ajmath/turn-tracker/hardware/enclosure/brace-bar-detail.png

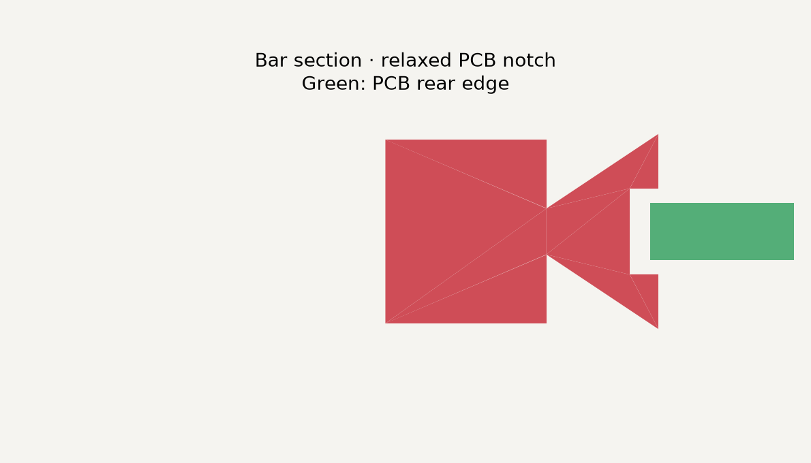
hardware/enclosure/brace-bar-detail.png
