ajmath/turn-tracker/hardware/enclosure/interface-details.png

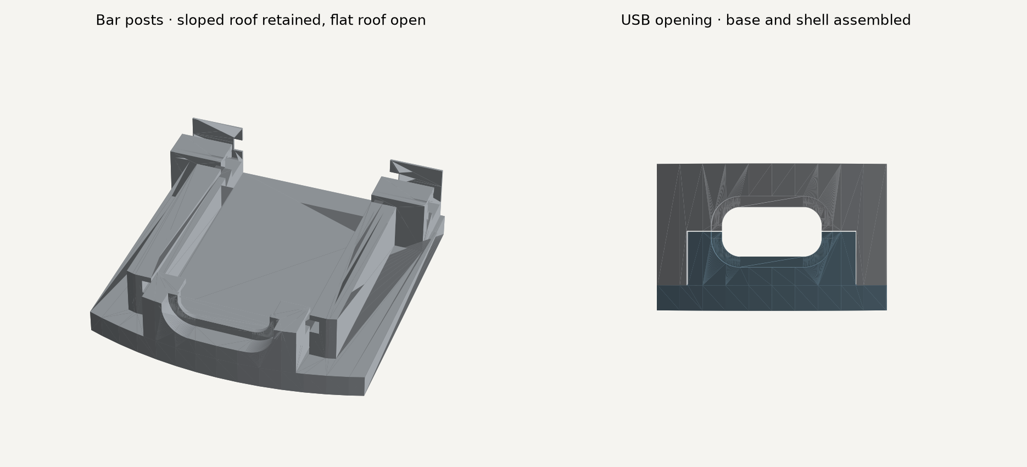
hardware/enclosure/interface-details.png
