ajmath/turn-tracker/hardware/enclosure/preview.png

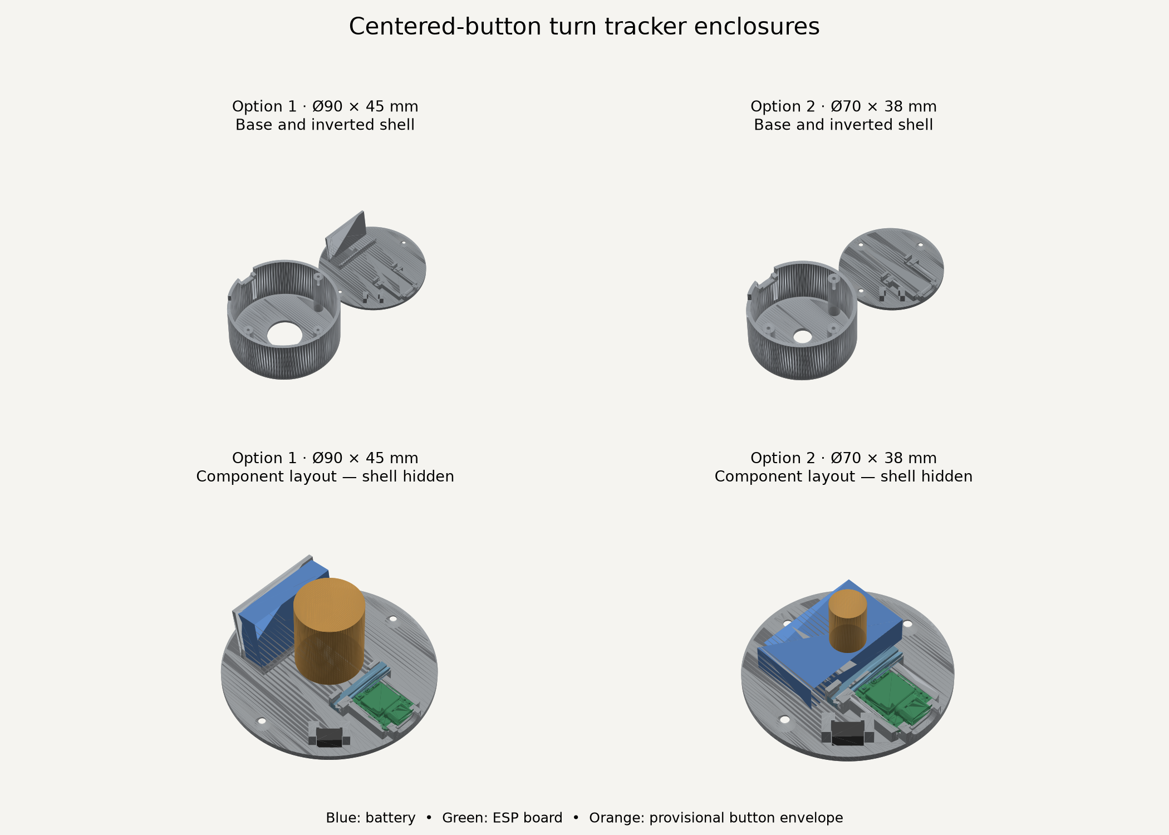
hardware/enclosure/preview.png
