ajmath/turn-tracker/hardware/enclosure/reference/usb.stl

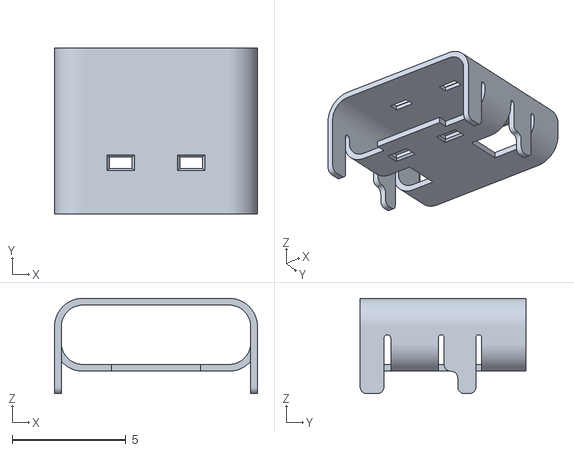
[picture p4: CAD file, 2026-11-03]
hardware/enclosure/reference/usb.stl
8.94 x 7.30 x 4.20
