ajmath/turn-tracker/hardware/enclosure/stl/option-2-component-layout-REFERENCE.stl

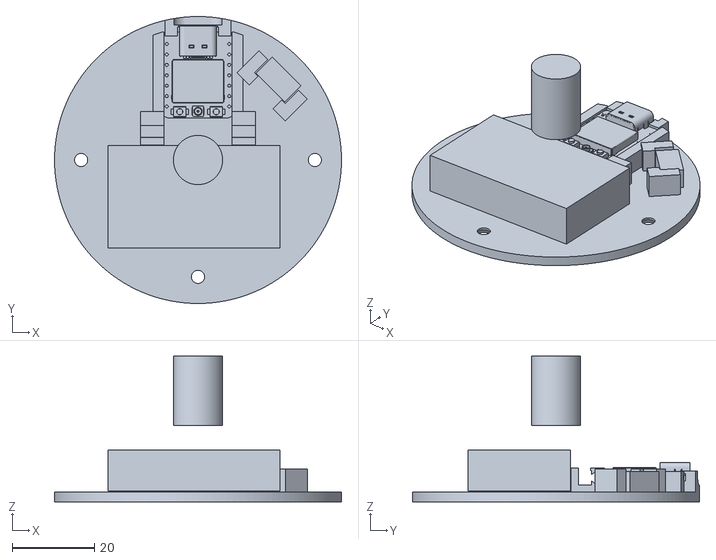
[picture p5: CAD file, 2026-11-06]
hardware/enclosure/stl/option-2-component-layout-REFERENCE.stl
70.0 x 70.0 x 35.6
