ajmath/turn-tracker/hardware/enclosure/reference/board.stl

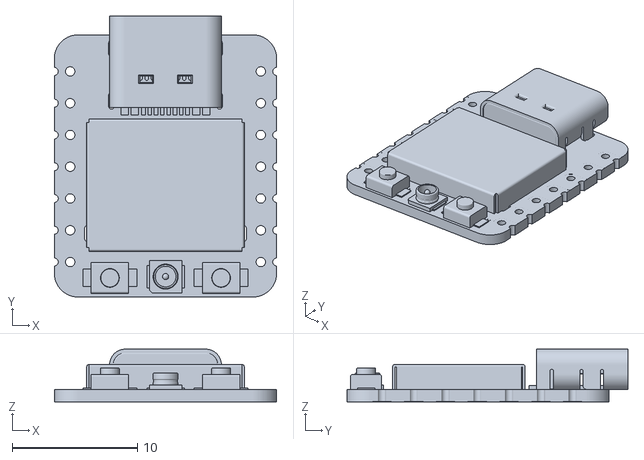
[picture p6: CAD file, 2026-11-03]
hardware/enclosure/reference/board.stl
17.8 x 22.5 x 4.21
