ajmath/turn-tracker/hardware/enclosure/stl/option-1-exploded.stl

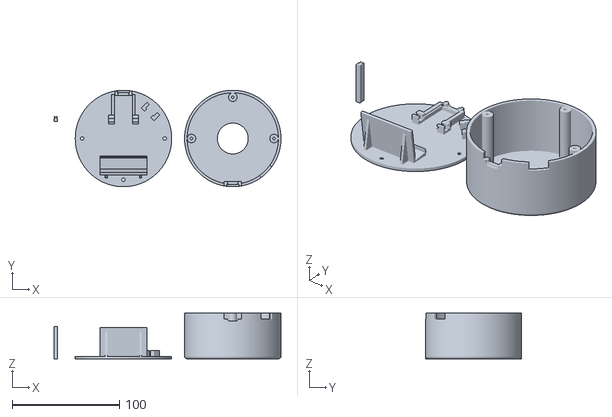
[picture p7: CAD file, 2026-11-06]
hardware/enclosure/stl/option-1-exploded.stl
211.8 x 90.0 x 42.6
