ajmath/turn-tracker/hardware/enclosure/stl/option-2-brace-bar.stl

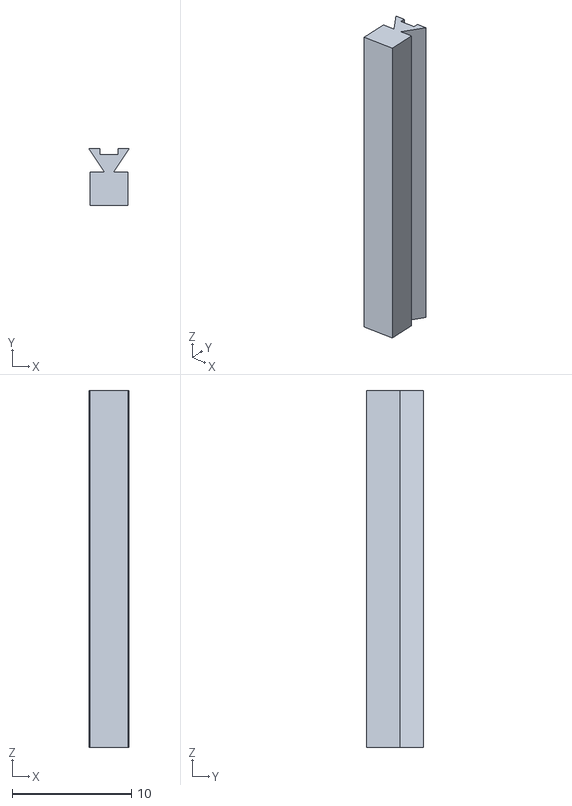
[picture p8: CAD file, 2026-11-06]
hardware/enclosure/stl/option-2-brace-bar.stl
3.40 x 4.75 x 30.0
