ajmath/turn-tracker/hardware/enclosure/stl/option-2-exploded.stl

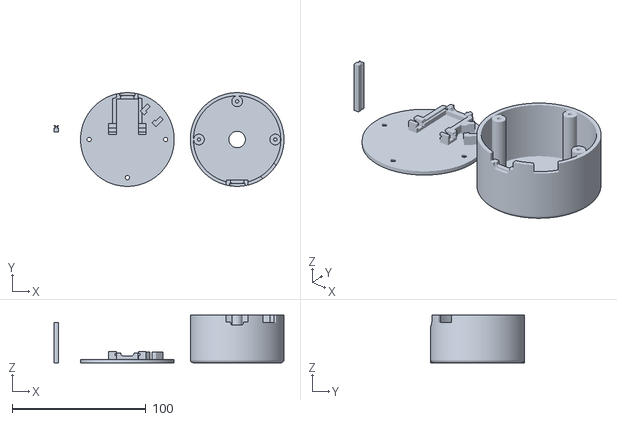
[picture p9: CAD file, 2026-11-06]
hardware/enclosure/stl/option-2-exploded.stl
171.8 x 70.0 x 35.6
