ajmath/turn-tracker/hardware/enclosure/stl/option-2-base.stl

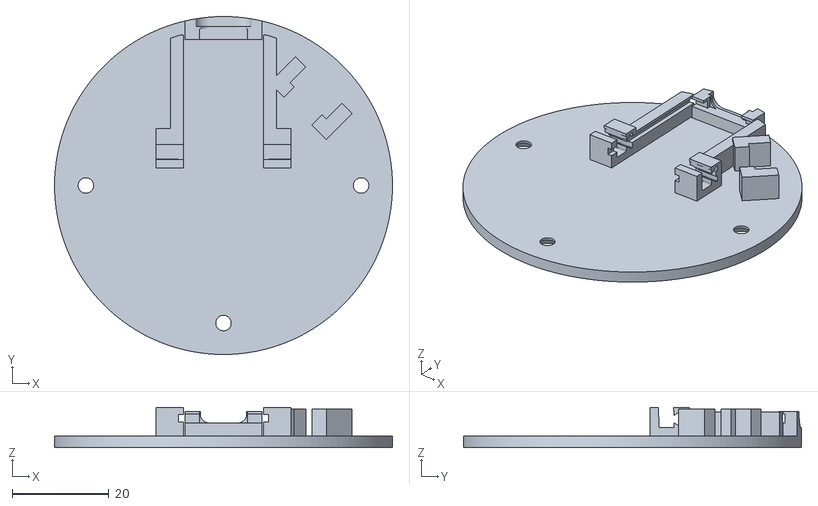
[picture p10: CAD file, 2026-11-06]
hardware/enclosure/stl/option-2-base.stl
70.0 x 70.0 x 8.30
