ajmath/turn-tracker/hardware/enclosure/stl/option-1-base.stl

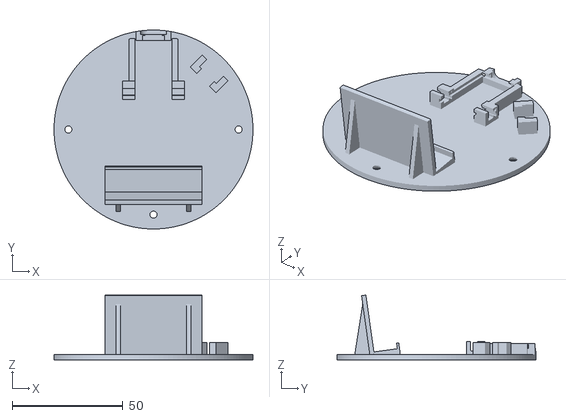
[picture p11: CAD file, 2026-11-06]
hardware/enclosure/stl/option-1-base.stl
90.0 x 90.0 x 29.3
