ajmath/turn-tracker/hardware/enclosure/stl/option-1-component-layout-REFERENCE.stl

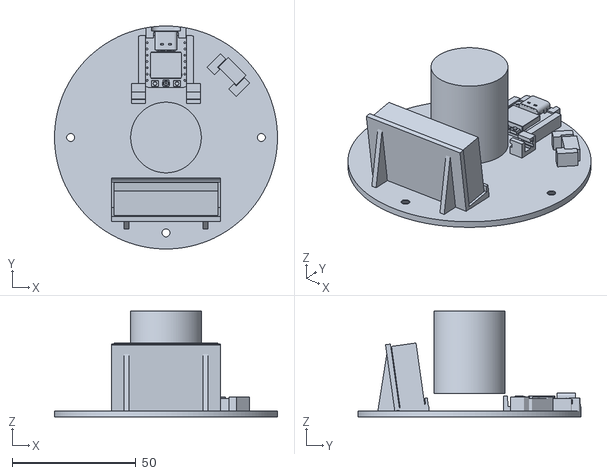
[picture p12: CAD file, 2026-11-06]
hardware/enclosure/stl/option-1-component-layout-REFERENCE.stl
90.0 x 90.0 x 42.6
