ajmath/turn-tracker/hardware/enclosure/stl/option-2-shell.stl

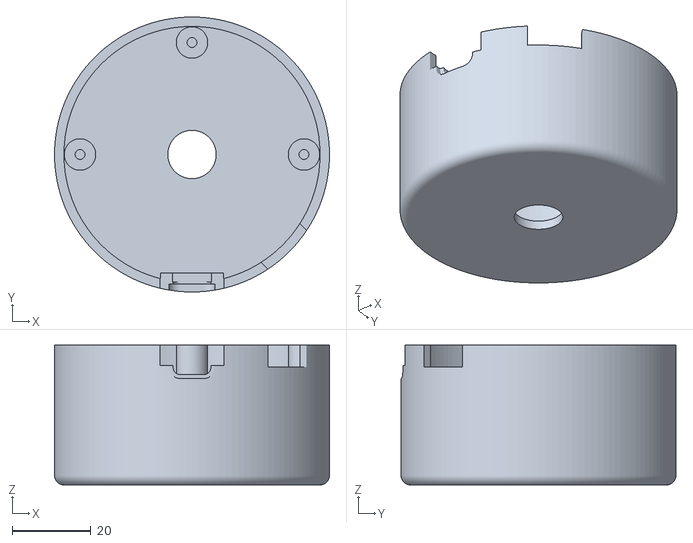
[picture p13: CAD file, 2026-11-03]
hardware/enclosure/stl/option-2-shell.stl
70.0 x 70.0 x 35.6
