ajmath/turn-tracker/hardware/enclosure/stl/option-1-shell.stl

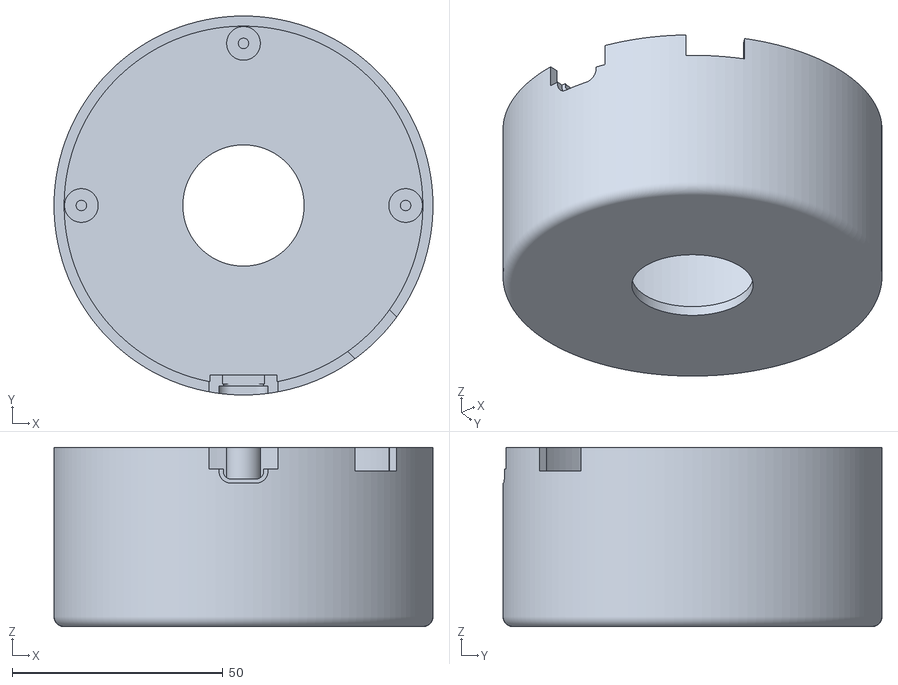
[picture p14: CAD file, 2026-11-03]
hardware/enclosure/stl/option-1-shell.stl
90.0 x 90.0 x 42.6
