ajmath/turn-tracker/hardware/enclosure/option-1.scad

// Option 1: centered button, 90 mm circular puck with local USB recess.
include <puck.scad>
option=1;
