ajmath/turn-tracker/hardware/enclosure/option-2.scad

// Option 2: centered button, 70 mm circular puck with local USB recess.
include <puck.scad>
option=2;
