ajmath/turn-tracker/hardware/enclosure/puck.scad

// Generated by generate.py: exact same CSG tree as the verified STL exports.
// Adjust dimensions in generate.py and regenerate to keep both formats equivalent.
option=1; part="assembly";
module o1_shell(){difference(){difference(){difference(){difference(){union(){difference(){difference(){difference(){difference(){union(){union(){union(){difference(){union(){union(){union(){union(){union(){union(){union(){union(){union(){union(){union(){union(){union(){union(){union(){union(){union(){union(){union(){union(){union(){union(){union(){union(){union(){union(){union(){union(){union(){union(){union(){union(){translate([0,0,2.4]){cylinder(r=45.0,h=40.2,$fn=128);}translate([0,0,42.6]){cylinder(h=0.11776241838580148,r1=45.0,r2=44.997109094892416,$fn=128);}}translate([0,0,42.7177624183858]){cylinder(h=0.11747871840514534,r1=44.997109094892416,r2=44.98844334401328,$fn=128);}}translate([0,0,42.83524113679095]){cylinder(h=0.11691200190192319,r1=44.98844334401328,r2=44.97402362391548,$fn=128);}}translate([0,0,42.95215313869287]){cylinder(h=0.11606363414583853,r1=44.97402362391548,r2=44.95388467296775,$fn=128);}}translate([0,0,43.06821677283871]){cylinder(h=0.11493565892912727,r1=44.95388467296775,r2=44.928075007666905,$fn=128);}}translate([0,0,43.18315243176784]){cylinder(h=0.1135307936428731,r1=44.928075007666905,r2=44.8966568057573,$fn=128);}}translate([0,0,43.29668322541071]){cylinder(h=0.11185242273062102,r1=44.8966568057573,r2=44.859705756439254,$fn=128);}}translate([0,0,43.40853564814133]){cylinder(h=0.10990458953488513,r1=44.859705756439254,r2=44.81731087802709,$fn=128);}}translate([0,0,43.51844023767622]){cylinder(h=0.1076919865564605,r1=44.81731087802709,r2=44.76957430349626,$fn=128);}}translate([0,0,43.62613222423268]){cylinder(h=0.10521994414971658,r1=44.76957430349626,r2=44.716611034436056,$fn=128);}}translate([0,0,43.731352168382394]){cylinder(h=0.10249441768134204,r1=44.716611034436056,r2=44.658548664000655,$fn=128);}}translate([0,0,43.833846586063736]){cylinder(h=0.09952197318330747,r1=44.658548664000655,r2=44.59552706952611,$fn=128);}}translate([0,0,43.93336855924704]){cylinder(h=0.09630977153479847,r1=44.59552706952611,r2=44.52769807555355,$fn=128);}}translate([0,0,44.02967833078184]){cylinder(h=0.092865551210906,r1=44.52769807555355,r2=44.45522508807057,$fn=128);}}translate([0,0,44.12254388199275]){cylinder(h=0.08919760964009527,r1=44.45522508807057,r2=44.378282700851905,$fn=128);}}translate([0,0,44.21174149163284]){cylinder(h=0.0853147832148693,r1=44.378282700851905,r2=44.29705627484771,$fn=128);}}translate([0,0,44.29705627484771]){cylinder(h=0.08122642600419283,r1=44.29705627484771,r2=44.21174149163284,$fn=128);}}translate([0,0,44.378282700851905]){cylinder(h=0.07694238721866498,r1=44.21174149163284,r2=44.12254388199275,$fn=128);}}translate([0,0,44.45522508807057]){cylinder(h=0.07247298748298192,r1=44.12254388199275,r2=44.02967833078184,$fn=128);}}translate([0,0,44.52769807555355]){cylinder(h=0.06782899397256159,r1=44.02967833078184,r2=43.93336855924705,$fn=128);}}translate([0,0,44.59552706952611]){cylinder(h=0.06302159447454159,r1=43.93336855924705,r2=43.833846586063736,$fn=128);}}translate([0,0,44.658548664000655]){cylinder(h=0.05806237043540108,r1=43.833846586063736,r2=43.731352168382394,$fn=128);}}translate([0,0,44.716611034436056]){cylinder(h=0.0529632690602071,r1=43.731352168382394,r2=43.62613222423268,$fn=128);}}translate([0,0,44.76957430349626]){cylinder(h=0.04773657453082336,r1=43.62613222423268,r2=43.51844023767622,$fn=128);}}translate([0,0,44.81731087802709]){cylinder(h=0.042394878412167714,r1=43.51844023767622,r2=43.40853564814133,$fn=128);}}translate([0,0,44.859705756439254]){cylinder(h=0.03695104931804849,r1=43.40853564814133,r2=43.29668322541071,$fn=128);}}translate([0,0,44.8966568057573]){cylinder(h=0.03141820190960232,r1=43.29668322541071,r2=43.18315243176784,$fn=128);}}translate([0,0,44.928075007666905]){cylinder(h=0.02580966530084794,r1=43.18315243176784,r2=43.06821677283871,$fn=128);}}translate([0,0,44.95388467296775]){cylinder(h=0.02013895094772522,r1=43.06821677283871,r2=42.95215313869287,$fn=128);}}translate([0,0,44.97402362391548]){cylinder(h=0.01441972009779846,r1=42.95215313869287,r2=42.83524113679095,$fn=128);}}translate([0,0,44.98844334401328]){cylinder(h=0.008665750879139011,r1=42.83524113679095,r2=42.7177624183858,$fn=128);}}translate([0,0,44.997109094892416]){cylinder(h=0.002890905107584274,r1=42.7177624183858,r2=42.6,$fn=128);}}translate([0,0,2.3]){cylinder(r=42.6,h=40.300000000000004,$fn=128);}}translate([38.5,0.0,2.4]){cylinder(r=4,h=40.2,$fn=128);}}translate([-38.5,4.7148901767173095e-15,2.4]){cylinder(r=4,h=40.2,$fn=128);}}translate([-7.072335265075964e-15,-38.5,2.4]){cylinder(r=4,h=40.2,$fn=128);}}translate([0,0,42.5]){cylinder(r=14.4,h=2.6999999999999997,$fn=128);}}translate([38.5,0.0,2.3]){cylinder(r=1.25,h=10,$fn=128);}}translate([-38.5,4.7148901767173095e-15,2.3]){cylinder(r=1.25,h=10,$fn=128);}}translate([-7.072335265075964e-15,-38.5,2.3]){cylinder(r=1.25,h=10,$fn=128);}}intersection(){translate([-8,40.2,2.4]){cube([16,5.799999999999997,9.6]);}translate([0,0,0]){cylinder(r=45.0,h=45,$fn=128);}}}translate([-8.15,40.050000000000004,2.35]){cube([16.3,6.799999999999997,5.26]);}}union(){union(){union(){union(){union(){union(){translate([-3.0,35.2,5.109999999999999]){cube([6.0,12,4.8]);}translate([-4.8,35.2,6.909999999999999]){cube([9.6,12,1.1999999999999997]);}}translate([-3.0,35.2,6.909999999999999]){rotate([-90,0,0]){translate([0,0,0]){cylinder(r=1.8,h=12,$fn=128);}}}}translate([-3.0,35.2,8.11]){rotate([-90,0,0]){translate([0,0,0]){cylinder(r=1.8,h=12,$fn=128);}}}}translate([3.0,35.2,6.909999999999999]){rotate([-90,0,0]){translate([0,0,0]){cylinder(r=1.8,h=12,$fn=128);}}}}translate([3.0,35.2,8.11]){rotate([-90,0,0]){translate([0,0,0]){cylinder(r=1.8,h=12,$fn=128);}}}}translate([-5,35.2,5.109999999999999]){cube([10,7.2,4.8]);}}}union(){union(){union(){union(){union(){translate([-3.0,42.9,4.109999999999999]){cube([6.0,5,6.8]);}translate([-5.8,42.9,6.909999999999999]){cube([11.6,5,1.2000000000000002]);}}translate([-3.0,42.9,6.909999999999999]){rotate([-90,0,0]){translate([0,0,0]){cylinder(r=2.8,h=5,$fn=128);}}}}translate([-3.0,42.9,8.11]){rotate([-90,0,0]){translate([0,0,0]){cylinder(r=2.8,h=5,$fn=128);}}}}translate([3.0,42.9,6.909999999999999]){rotate([-90,0,0]){translate([0,0,0]){cylinder(r=2.8,h=5,$fn=128);}}}}translate([3.0,42.9,8.11]){rotate([-90,0,0]){translate([0,0,0]){cylinder(r=2.8,h=5,$fn=128);}}}}}rotate([0,0,45]){translate([37.0,-7,2.3]){cube([10,14,5.7]);}}}}
module o1_base(){union(){union(){union(){union(){union(){difference(){difference(){difference(){difference(){difference(){difference(){translate([0,0,0]){cylinder(r=45.0,h=2.4,$fn=128);}translate([38.5,0.0,-0.1]){cylinder(r=1.6,h=2.6,$fn=128);}}translate([38.5,0.0,-0.1]){cylinder(h=2.0,r1=3.6,r2=1.6,$fn=128);}}translate([-38.5,4.7148901767173095e-15,-0.1]){cylinder(r=1.6,h=2.6,$fn=128);}}translate([-38.5,4.7148901767173095e-15,-0.1]){cylinder(h=2.0,r1=3.6,r2=1.6,$fn=128);}}translate([-7.072335265075964e-15,-38.5,-0.1]){cylinder(r=1.6,h=2.6,$fn=128);}}translate([-7.072335265075964e-15,-38.5,-0.1]){cylinder(h=2.0,r1=3.6,r2=1.6,$fn=128);}}difference(){difference(){difference(){intersection(){translate([-8,40.2,2.4]){cube([16,5.799999999999997,5.109999999999999]);}translate([0,0,0]){cylinder(r=45.0,h=45,$fn=128);}}translate([-12,40.1,5.1000000000000005]){cube([24,1.5,1.8]);}}union(){union(){union(){union(){union(){union(){translate([-3.0,35.2,5.109999999999999]){cube([6.0,12,4.8]);}translate([-4.8,35.2,6.909999999999999]){cube([9.6,12,1.1999999999999997]);}}translate([-3.0,35.2,6.909999999999999]){rotate([-90,0,0]){translate([0,0,0]){cylinder(r=1.8,h=12,$fn=128);}}}}translate([-3.0,35.2,8.11]){rotate([-90,0,0]){translate([0,0,0]){cylinder(r=1.8,h=12,$fn=128);}}}}translate([3.0,35.2,6.909999999999999]){rotate([-90,0,0]){translate([0,0,0]){cylinder(r=1.8,h=12,$fn=128);}}}}translate([3.0,35.2,8.11]){rotate([-90,0,0]){translate([0,0,0]){cylinder(r=1.8,h=12,$fn=128);}}}}translate([-5,35.2,5.109999999999999]){cube([10,7.2,4.8]);}}}union(){union(){union(){union(){union(){translate([-3.0,42.9,4.109999999999999]){cube([6.0,5,6.8]);}translate([-5.8,42.9,6.909999999999999]){cube([11.6,5,1.2000000000000002]);}}translate([-3.0,42.9,6.909999999999999]){rotate([-90,0,0]){translate([0,0,0]){cylinder(r=2.8,h=5,$fn=128);}}}}translate([-3.0,42.9,8.11]){rotate([-90,0,0]){translate([0,0,0]){cylinder(r=2.8,h=5,$fn=128);}}}}translate([3.0,42.9,6.909999999999999]){rotate([-90,0,0]){translate([0,0,0]){cylinder(r=2.8,h=5,$fn=128);}}}}translate([3.0,42.9,8.11]){rotate([-90,0,0]){translate([0,0,0]){cylinder(r=2.8,h=5,$fn=128);}}}}}}intersection(){difference(){difference(){union(){translate([-11,20.245000000000005,2.3]){cube([2.7,20.955,5.1]);}difference(){difference(){translate([-14,13.645000000000005,2.3]){cube([5.7,8.2,6.0]);}translate([-20,20.245000000000005,5.4]){rotate([90,0,90]){linear_extrude(height=40){offset(r=0.2,$fn=64){polygon(points=[[-4.6, -1.1], [-1.8, -1.1], [-1.8, 0.1], [0.15, -1.2], [0.15, -0.25], [-0.35, -0.25], [-0.35, 1.25], [0.15, 1.25], [0.15, 2.2], [-1.8, 0.9], [-1.8, 2.1], [-4.6, 2.1]]);}}}}}translate([-20,15.435000000000006,6.300000000000001]){cube([40,3.01,10]);}}}translate([-9.29,13.545000000000005,5.300000000000001]){cube([18.58,30,1.5]);}}translate([-20,20.245000000000005,5.4]){rotate([90,0,90]){linear_extrude(height=40){offset(r=0.2,$fn=64){polygon(points=[[-4.6, -1.1], [-1.8, -1.1], [-1.8, 0.1], [0.15, -1.2], [0.15, -0.25], [-0.35, -0.25], [-0.35, 1.25], [0.15, 1.25], [0.15, 2.2], [-1.8, 0.9], [-1.8, 2.1], [-4.6, 2.1]]);}}}}}translate([0,0,0]){cylinder(r=42.4,h=45,$fn=128);}}}intersection(){difference(){difference(){union(){translate([8.3,20.245000000000005,2.3]){cube([2.7,20.955,5.1]);}difference(){difference(){translate([8.3,13.645000000000005,2.3]){cube([5.7,8.2,6.0]);}translate([-20,20.245000000000005,5.4]){rotate([90,0,90]){linear_extrude(height=40){offset(r=0.2,$fn=64){polygon(points=[[-4.6, -1.1], [-1.8, -1.1], [-1.8, 0.1], [0.15, -1.2], [0.15, -0.25], [-0.35, -0.25], [-0.35, 1.25], [0.15, 1.25], [0.15, 2.2], [-1.8, 0.9], [-1.8, 2.1], [-4.6, 2.1]]);}}}}}translate([-20,15.435000000000006,6.300000000000001]){cube([40,3.01,10]);}}}translate([-9.29,13.545000000000005,5.300000000000001]){cube([18.58,30,1.5]);}}translate([-20,20.245000000000005,5.4]){rotate([90,0,90]){linear_extrude(height=40){offset(r=0.2,$fn=64){polygon(points=[[-4.6, -1.1], [-1.8, -1.1], [-1.8, 0.1], [0.15, -1.2], [0.15, -0.25], [-0.35, -0.25], [-0.35, 1.25], [0.15, 1.25], [0.15, 2.2], [-1.8, 0.9], [-1.8, 2.1], [-4.6, 2.1]]);}}}}}translate([0,0,0]){cylinder(r=42.4,h=45,$fn=128);}}}union(){union(){union(){translate([0,-28.3,3.5999999999999996]){rotate([8,0,0]){union(){union(){translate([-22,-2,-1]){cube([44,2,27]);}translate([-22,0,-1.2]){cube([44,11.7,1.2]);}}translate([-22,10.7,-1.2]){cube([44,1,3.7]);}}}}translate([-17,0,2.3]){rotate([90,0,90]){translate([0,0,0]){linear_extrude(height=2) polygon(points=[[-37, 0], [-30.2, 0], [-32.9, 26]]);}}}}translate([15,0,2.3]){rotate([90,0,90]){translate([0,0,0]){linear_extrude(height=2) polygon(points=[[-37, 0], [-30.2, 0], [-32.9, 26]]);}}}}translate([-22,0,2.3]){rotate([90,0,90]){translate([0,0,0]){linear_extrude(height=44) polygon(points=[[-28.3, 0], [-16.4, 0], [-16.4, 1.811], [-28.3, 0.138]]);}}}}}rotate([0,0,45]){union(){union(){union(){translate([31.8,-8.3,2.3]){cube([7.6,3,5.7]);}translate([31.8,-8.3,2.3]){cube([3,4.2,5.7]);}}translate([31.8,5.3,2.3]){cube([7.6,3,5.7]);}}translate([31.8,4.1,2.3]){cube([3,4.2,5.7]);}}}}}
module o1_brace_bar(){translate([-15,20.245000000000005,5.4]){rotate([90,0,90]){linear_extrude(height=30){polygon(points=[[-4.6, -1.1], [-1.8, -1.1], [-1.8, 0.1], [0.15, -1.2], [0.15, -0.25], [-0.35, -0.25], [-0.35, 1.25], [0.15, 1.25], [0.15, 2.2], [-1.8, 0.9], [-1.8, 2.1], [-4.6, 2.1]]);}}}}
module o1_reference_battery(){translate([0,-28.3,3.5999999999999996]){rotate([8,0,0]){translate([-21,0.3,0]){cube([42,10,25]);}}}}
module o1_reference_esp(){translate([0,41.2,5.4]){import("reference/board.stl");}}
module o1_reference_button(){translate([0,0,9.300000000000004]){cylinder(r=14.25,h=33.3,$fn=128);}}
module o1_reference_switch(){rotate([0,0,45]){translate([35.0,-5,2.4]){cube([5.6,10,5]);}}}
module o1_reference_usb(){translate([0,41.2,5.4]){import("reference/usb.stl");}}
if(option==1){
if(part=="shell") translate([0,0,45]) rotate([180,0,0]) o1_shell();
if(part=="base") o1_base();
if(part=="brace-bar") translate([0,0,15]) rotate([0,90,0]) o1_brace_bar();
if(part=="assembly"||part=="layout"){
if(part=="assembly") color([.8,.8,.85,.3]) o1_shell();
o1_base();
color([.25,.55,.95,.8]) o1_reference_battery();
color([.1,.65,.3]) o1_reference_esp();
color([.95,.55,.1,.6]) o1_reference_button();
color([.2,.2,.2]) o1_reference_switch();
color([.6,.6,.6]) o1_reference_usb();
color([.4,.6,.8]) o1_brace_bar();
}
}
module o2_shell(){difference(){difference(){difference(){difference(){union(){difference(){difference(){difference(){difference(){union(){union(){union(){difference(){union(){union(){union(){union(){union(){union(){union(){union(){union(){union(){union(){union(){union(){union(){union(){union(){union(){union(){union(){union(){union(){union(){union(){union(){union(){union(){union(){union(){union(){union(){union(){union(){translate([0,0,2.4]){cylinder(r=35.0,h=33.2,$fn=128);}translate([0,0,35.6]){cylinder(h=0.11776241838580148,r1=35.0,r2=34.997109094892416,$fn=128);}}translate([0,0,35.7177624183858]){cylinder(h=0.11747871840514534,r1=34.997109094892416,r2=34.98844334401328,$fn=128);}}translate([0,0,35.83524113679095]){cylinder(h=0.11691200190192319,r1=34.98844334401328,r2=34.97402362391548,$fn=128);}}translate([0,0,35.95215313869287]){cylinder(h=0.11606363414583853,r1=34.97402362391548,r2=34.95388467296775,$fn=128);}}translate([0,0,36.06821677283871]){cylinder(h=0.11493565892912727,r1=34.95388467296775,r2=34.928075007666905,$fn=128);}}translate([0,0,36.18315243176784]){cylinder(h=0.1135307936428731,r1=34.928075007666905,r2=34.8966568057573,$fn=128);}}translate([0,0,36.29668322541071]){cylinder(h=0.11185242273062102,r1=34.8966568057573,r2=34.859705756439254,$fn=128);}}translate([0,0,36.40853564814133]){cylinder(h=0.10990458953488513,r1=34.859705756439254,r2=34.81731087802709,$fn=128);}}translate([0,0,36.51844023767622]){cylinder(h=0.1076919865564605,r1=34.81731087802709,r2=34.76957430349626,$fn=128);}}translate([0,0,36.62613222423268]){cylinder(h=0.10521994414971658,r1=34.76957430349626,r2=34.716611034436056,$fn=128);}}translate([0,0,36.731352168382394]){cylinder(h=0.10249441768134204,r1=34.716611034436056,r2=34.658548664000655,$fn=128);}}translate([0,0,36.833846586063736]){cylinder(h=0.09952197318330747,r1=34.658548664000655,r2=34.59552706952611,$fn=128);}}translate([0,0,36.93336855924704]){cylinder(h=0.09630977153479847,r1=34.59552706952611,r2=34.52769807555355,$fn=128);}}translate([0,0,37.02967833078184]){cylinder(h=0.092865551210906,r1=34.52769807555355,r2=34.45522508807057,$fn=128);}}translate([0,0,37.12254388199275]){cylinder(h=0.08919760964009527,r1=34.45522508807057,r2=34.378282700851905,$fn=128);}}translate([0,0,37.21174149163284]){cylinder(h=0.0853147832148693,r1=34.378282700851905,r2=34.29705627484771,$fn=128);}}translate([0,0,37.29705627484771]){cylinder(h=0.08122642600419283,r1=34.29705627484771,r2=34.21174149163284,$fn=128);}}translate([0,0,37.378282700851905]){cylinder(h=0.07694238721866498,r1=34.21174149163284,r2=34.12254388199275,$fn=128);}}translate([0,0,37.45522508807057]){cylinder(h=0.07247298748298192,r1=34.12254388199275,r2=34.02967833078184,$fn=128);}}translate([0,0,37.52769807555355]){cylinder(h=0.06782899397256159,r1=34.02967833078184,r2=33.93336855924705,$fn=128);}}translate([0,0,37.59552706952611]){cylinder(h=0.06302159447454159,r1=33.93336855924705,r2=33.833846586063736,$fn=128);}}translate([0,0,37.658548664000655]){cylinder(h=0.05806237043540108,r1=33.833846586063736,r2=33.731352168382394,$fn=128);}}translate([0,0,37.716611034436056]){cylinder(h=0.0529632690602071,r1=33.731352168382394,r2=33.62613222423268,$fn=128);}}translate([0,0,37.76957430349626]){cylinder(h=0.04773657453082336,r1=33.62613222423268,r2=33.51844023767622,$fn=128);}}translate([0,0,37.81731087802709]){cylinder(h=0.042394878412167714,r1=33.51844023767622,r2=33.40853564814133,$fn=128);}}translate([0,0,37.859705756439254]){cylinder(h=0.03695104931804849,r1=33.40853564814133,r2=33.29668322541071,$fn=128);}}translate([0,0,37.8966568057573]){cylinder(h=0.03141820190960232,r1=33.29668322541071,r2=33.18315243176784,$fn=128);}}translate([0,0,37.928075007666905]){cylinder(h=0.02580966530084794,r1=33.18315243176784,r2=33.06821677283871,$fn=128);}}translate([0,0,37.95388467296775]){cylinder(h=0.02013895094772522,r1=33.06821677283871,r2=32.95215313869287,$fn=128);}}translate([0,0,37.97402362391548]){cylinder(h=0.01441972009779846,r1=32.95215313869287,r2=32.83524113679095,$fn=128);}}translate([0,0,37.98844334401328]){cylinder(h=0.008665750879139011,r1=32.83524113679095,r2=32.7177624183858,$fn=128);}}translate([0,0,37.997109094892416]){cylinder(h=0.002890905107584274,r1=32.7177624183858,r2=32.6,$fn=128);}}translate([0,0,2.3]){cylinder(r=32.6,h=33.300000000000004,$fn=128);}}translate([28.5,0.0,2.4]){cylinder(r=4,h=33.2,$fn=128);}}translate([-28.5,3.4902433775699565e-15,2.4]){cylinder(r=4,h=33.2,$fn=128);}}translate([-5.235365066354935e-15,-28.5,2.4]){cylinder(r=4,h=33.2,$fn=128);}}translate([0,0,35.5]){cylinder(r=6.15,h=2.6999999999999997,$fn=128);}}translate([28.5,0.0,2.3]){cylinder(r=1.25,h=10,$fn=128);}}translate([-28.5,3.4902433775699565e-15,2.3]){cylinder(r=1.25,h=10,$fn=128);}}translate([-5.235365066354935e-15,-28.5,2.3]){cylinder(r=1.25,h=10,$fn=128);}}intersection(){translate([-8,30.2,2.4]){cube([16,5.800000000000001,9.6]);}translate([0,0,0]){cylinder(r=35.0,h=38,$fn=128);}}}translate([-8.15,30.05,2.35]){cube([16.3,6.800000000000001,5.26]);}}union(){union(){union(){union(){union(){union(){translate([-3.0,25.2,5.109999999999999]){cube([6.0,12,4.8]);}translate([-4.8,25.2,6.909999999999999]){cube([9.6,12,1.1999999999999997]);}}translate([-3.0,25.2,6.909999999999999]){rotate([-90,0,0]){translate([0,0,0]){cylinder(r=1.8,h=12,$fn=128);}}}}translate([-3.0,25.2,8.11]){rotate([-90,0,0]){translate([0,0,0]){cylinder(r=1.8,h=12,$fn=128);}}}}translate([3.0,25.2,6.909999999999999]){rotate([-90,0,0]){translate([0,0,0]){cylinder(r=1.8,h=12,$fn=128);}}}}translate([3.0,25.2,8.11]){rotate([-90,0,0]){translate([0,0,0]){cylinder(r=1.8,h=12,$fn=128);}}}}translate([-5,25.2,5.109999999999999]){cube([10,7.2,4.8]);}}}union(){union(){union(){union(){union(){translate([-3.0,32.9,4.109999999999999]){cube([6.0,5,6.8]);}translate([-5.8,32.9,6.909999999999999]){cube([11.6,5,1.2000000000000002]);}}translate([-3.0,32.9,6.909999999999999]){rotate([-90,0,0]){translate([0,0,0]){cylinder(r=2.8,h=5,$fn=128);}}}}translate([-3.0,32.9,8.11]){rotate([-90,0,0]){translate([0,0,0]){cylinder(r=2.8,h=5,$fn=128);}}}}translate([3.0,32.9,6.909999999999999]){rotate([-90,0,0]){translate([0,0,0]){cylinder(r=2.8,h=5,$fn=128);}}}}translate([3.0,32.9,8.11]){rotate([-90,0,0]){translate([0,0,0]){cylinder(r=2.8,h=5,$fn=128);}}}}}rotate([0,0,45]){translate([27.0,-7,2.3]){cube([10,14,5.7]);}}}}
module o2_base(){union(){union(){union(){union(){difference(){difference(){difference(){difference(){difference(){difference(){translate([0,0,0]){cylinder(r=35.0,h=2.4,$fn=128);}translate([28.5,0.0,-0.1]){cylinder(r=1.6,h=2.6,$fn=128);}}translate([28.5,0.0,-0.1]){cylinder(h=2.0,r1=3.6,r2=1.6,$fn=128);}}translate([-28.5,3.4902433775699565e-15,-0.1]){cylinder(r=1.6,h=2.6,$fn=128);}}translate([-28.5,3.4902433775699565e-15,-0.1]){cylinder(h=2.0,r1=3.6,r2=1.6,$fn=128);}}translate([-5.235365066354935e-15,-28.5,-0.1]){cylinder(r=1.6,h=2.6,$fn=128);}}translate([-5.235365066354935e-15,-28.5,-0.1]){cylinder(h=2.0,r1=3.6,r2=1.6,$fn=128);}}difference(){difference(){difference(){intersection(){translate([-8,30.2,2.4]){cube([16,5.800000000000001,5.109999999999999]);}translate([0,0,0]){cylinder(r=35.0,h=38,$fn=128);}}translate([-12,30.099999999999998,5.1000000000000005]){cube([24,1.5,1.8]);}}union(){union(){union(){union(){union(){union(){translate([-3.0,25.2,5.109999999999999]){cube([6.0,12,4.8]);}translate([-4.8,25.2,6.909999999999999]){cube([9.6,12,1.1999999999999997]);}}translate([-3.0,25.2,6.909999999999999]){rotate([-90,0,0]){translate([0,0,0]){cylinder(r=1.8,h=12,$fn=128);}}}}translate([-3.0,25.2,8.11]){rotate([-90,0,0]){translate([0,0,0]){cylinder(r=1.8,h=12,$fn=128);}}}}translate([3.0,25.2,6.909999999999999]){rotate([-90,0,0]){translate([0,0,0]){cylinder(r=1.8,h=12,$fn=128);}}}}translate([3.0,25.2,8.11]){rotate([-90,0,0]){translate([0,0,0]){cylinder(r=1.8,h=12,$fn=128);}}}}translate([-5,25.2,5.109999999999999]){cube([10,7.2,4.8]);}}}union(){union(){union(){union(){union(){translate([-3.0,32.9,4.109999999999999]){cube([6.0,5,6.8]);}translate([-5.8,32.9,6.909999999999999]){cube([11.6,5,1.2000000000000002]);}}translate([-3.0,32.9,6.909999999999999]){rotate([-90,0,0]){translate([0,0,0]){cylinder(r=2.8,h=5,$fn=128);}}}}translate([-3.0,32.9,8.11]){rotate([-90,0,0]){translate([0,0,0]){cylinder(r=2.8,h=5,$fn=128);}}}}translate([3.0,32.9,6.909999999999999]){rotate([-90,0,0]){translate([0,0,0]){cylinder(r=2.8,h=5,$fn=128);}}}}translate([3.0,32.9,8.11]){rotate([-90,0,0]){translate([0,0,0]){cylinder(r=2.8,h=5,$fn=128);}}}}}}intersection(){difference(){difference(){union(){translate([-11,10.245000000000001,2.3]){cube([2.7,20.955,5.1]);}difference(){difference(){translate([-14,3.6450000000000014,2.3]){cube([5.7,8.2,6.0]);}translate([-20,10.245000000000001,5.4]){rotate([90,0,90]){linear_extrude(height=40){offset(r=0.2,$fn=64){polygon(points=[[-4.6, -1.1], [-1.8, -1.1], [-1.8, 0.1], [0.15, -1.2], [0.15, -0.25], [-0.35, -0.25], [-0.35, 1.25], [0.15, 1.25], [0.15, 2.2], [-1.8, 0.9], [-1.8, 2.1], [-4.6, 2.1]]);}}}}}translate([-20,5.435000000000001,6.300000000000001]){cube([40,3.01,10]);}}}translate([-9.29,3.545000000000001,5.300000000000001]){cube([18.58,30,1.5]);}}translate([-20,10.245000000000001,5.4]){rotate([90,0,90]){linear_extrude(height=40){offset(r=0.2,$fn=64){polygon(points=[[-4.6, -1.1], [-1.8, -1.1], [-1.8, 0.1], [0.15, -1.2], [0.15, -0.25], [-0.35, -0.25], [-0.35, 1.25], [0.15, 1.25], [0.15, 2.2], [-1.8, 0.9], [-1.8, 2.1], [-4.6, 2.1]]);}}}}}translate([0,0,0]){cylinder(r=32.4,h=38,$fn=128);}}}intersection(){difference(){difference(){union(){translate([8.3,10.245000000000001,2.3]){cube([2.7,20.955,5.1]);}difference(){difference(){translate([8.3,3.6450000000000014,2.3]){cube([5.7,8.2,6.0]);}translate([-20,10.245000000000001,5.4]){rotate([90,0,90]){linear_extrude(height=40){offset(r=0.2,$fn=64){polygon(points=[[-4.6, -1.1], [-1.8, -1.1], [-1.8, 0.1], [0.15, -1.2], [0.15, -0.25], [-0.35, -0.25], [-0.35, 1.25], [0.15, 1.25], [0.15, 2.2], [-1.8, 0.9], [-1.8, 2.1], [-4.6, 2.1]]);}}}}}translate([-20,5.435000000000001,6.300000000000001]){cube([40,3.01,10]);}}}translate([-9.29,3.545000000000001,5.300000000000001]){cube([18.58,30,1.5]);}}translate([-20,10.245000000000001,5.4]){rotate([90,0,90]){linear_extrude(height=40){offset(r=0.2,$fn=64){polygon(points=[[-4.6, -1.1], [-1.8, -1.1], [-1.8, 0.1], [0.15, -1.2], [0.15, -0.25], [-0.35, -0.25], [-0.35, 1.25], [0.15, 1.25], [0.15, 2.2], [-1.8, 0.9], [-1.8, 2.1], [-4.6, 2.1]]);}}}}}translate([0,0,0]){cylinder(r=32.4,h=38,$fn=128);}}}rotate([0,0,45]){union(){union(){union(){translate([21.8,-8.3,2.3]){cube([7.6,3,5.7]);}translate([21.8,-8.3,2.3]){cube([3,4.2,5.7]);}}translate([21.8,5.3,2.3]){cube([7.6,3,5.7]);}}translate([21.8,4.1,2.3]){cube([3,4.2,5.7]);}}}}}
module o2_brace_bar(){translate([-15,10.245000000000001,5.4]){rotate([90,0,90]){linear_extrude(height=30){polygon(points=[[-4.6, -1.1], [-1.8, -1.1], [-1.8, 0.1], [0.15, -1.2], [0.15, -0.25], [-0.35, -0.25], [-0.35, 1.25], [0.15, 1.25], [0.15, 2.2], [-1.8, 0.9], [-1.8, 2.1], [-4.6, 2.1]]);}}}}
module o2_reference_battery(){translate([-22,-21.5,2.6999999999999997]){cube([42,25,10]);}}
module o2_reference_esp(){translate([0,31.2,5.4]){import("reference/board.stl");}}
module o2_reference_button(){translate([0,0,18.6]){cylinder(r=6.0,h=17,$fn=128);}}
module o2_reference_switch(){rotate([0,0,45]){translate([25.0,-5,2.4]){cube([5.6,10,5]);}}}
module o2_reference_usb(){translate([0,31.2,5.4]){import("reference/usb.stl");}}
if(option==2){
if(part=="shell") translate([0,0,38]) rotate([180,0,0]) o2_shell();
if(part=="base") o2_base();
if(part=="brace-bar") translate([0,0,15]) rotate([0,90,0]) o2_brace_bar();
if(part=="assembly"||part=="layout"){
if(part=="assembly") color([.8,.8,.85,.3]) o2_shell();
o2_base();
color([.25,.55,.95,.8]) o2_reference_battery();
color([.1,.65,.3]) o2_reference_esp();
color([.95,.55,.1,.6]) o2_reference_button();
color([.2,.2,.2]) o2_reference_switch();
color([.6,.6,.6]) o2_reference_usb();
color([.4,.6,.8]) o2_brace_bar();
}
}
