ajmath/turn-tracker/(list of files, cad)

Other CAD files:
hardware/enclosure/stl/option-1-brace-bar.stl
