ajmath/turn-tracker/(commit log)

2026-11-03 Fix GCC misleading indentation errors in CI
    [node.hpp, storage.hpp]
2026-11-03 Add printable turn-tracker enclosure designs and CAD exports
    [board.stl, option-1-base.stl, option-1-brace-bar.stl, option-1-component-layout-REFERENCE.stl, option-1-exploded.stl, option-1-shell.stl, option-1.scad, option-2-base.stl]
2026-11-03 Refine enclosure fits and reinforce printed mounts
    [option-1-base.stl, option-1-brace-bar.stl, option-1-component-layout-REFERENCE.stl, option-1-exploded.stl, option-2-base.stl, option-2-brace-bar.stl, option-2-component-layout-REFERENCE.stl, option-2-exploded.stl]
2026-11-06 Refine enclosure screw seats and component fit
    [option-1-base.stl, option-1-brace-bar.stl, option-1-component-layout-REFERENCE.stl, option-1-exploded.stl, option-2-base.stl, option-2-brace-bar.stl, option-2-component-layout-REFERENCE.stl, option-2-exploded.stl]
